221robotics/RobotOpen-Pneumatic-Shield/sunstone.png

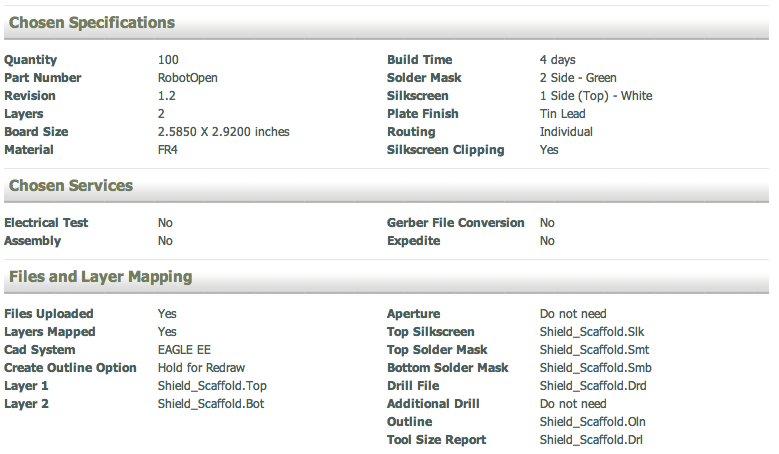
sunstone.png
