221robotics/RobotOpen-Pneumatic-Shield/pneumatic_board2.brd

## EAGLE design pneumatic_board2.brd (2012-09-11)

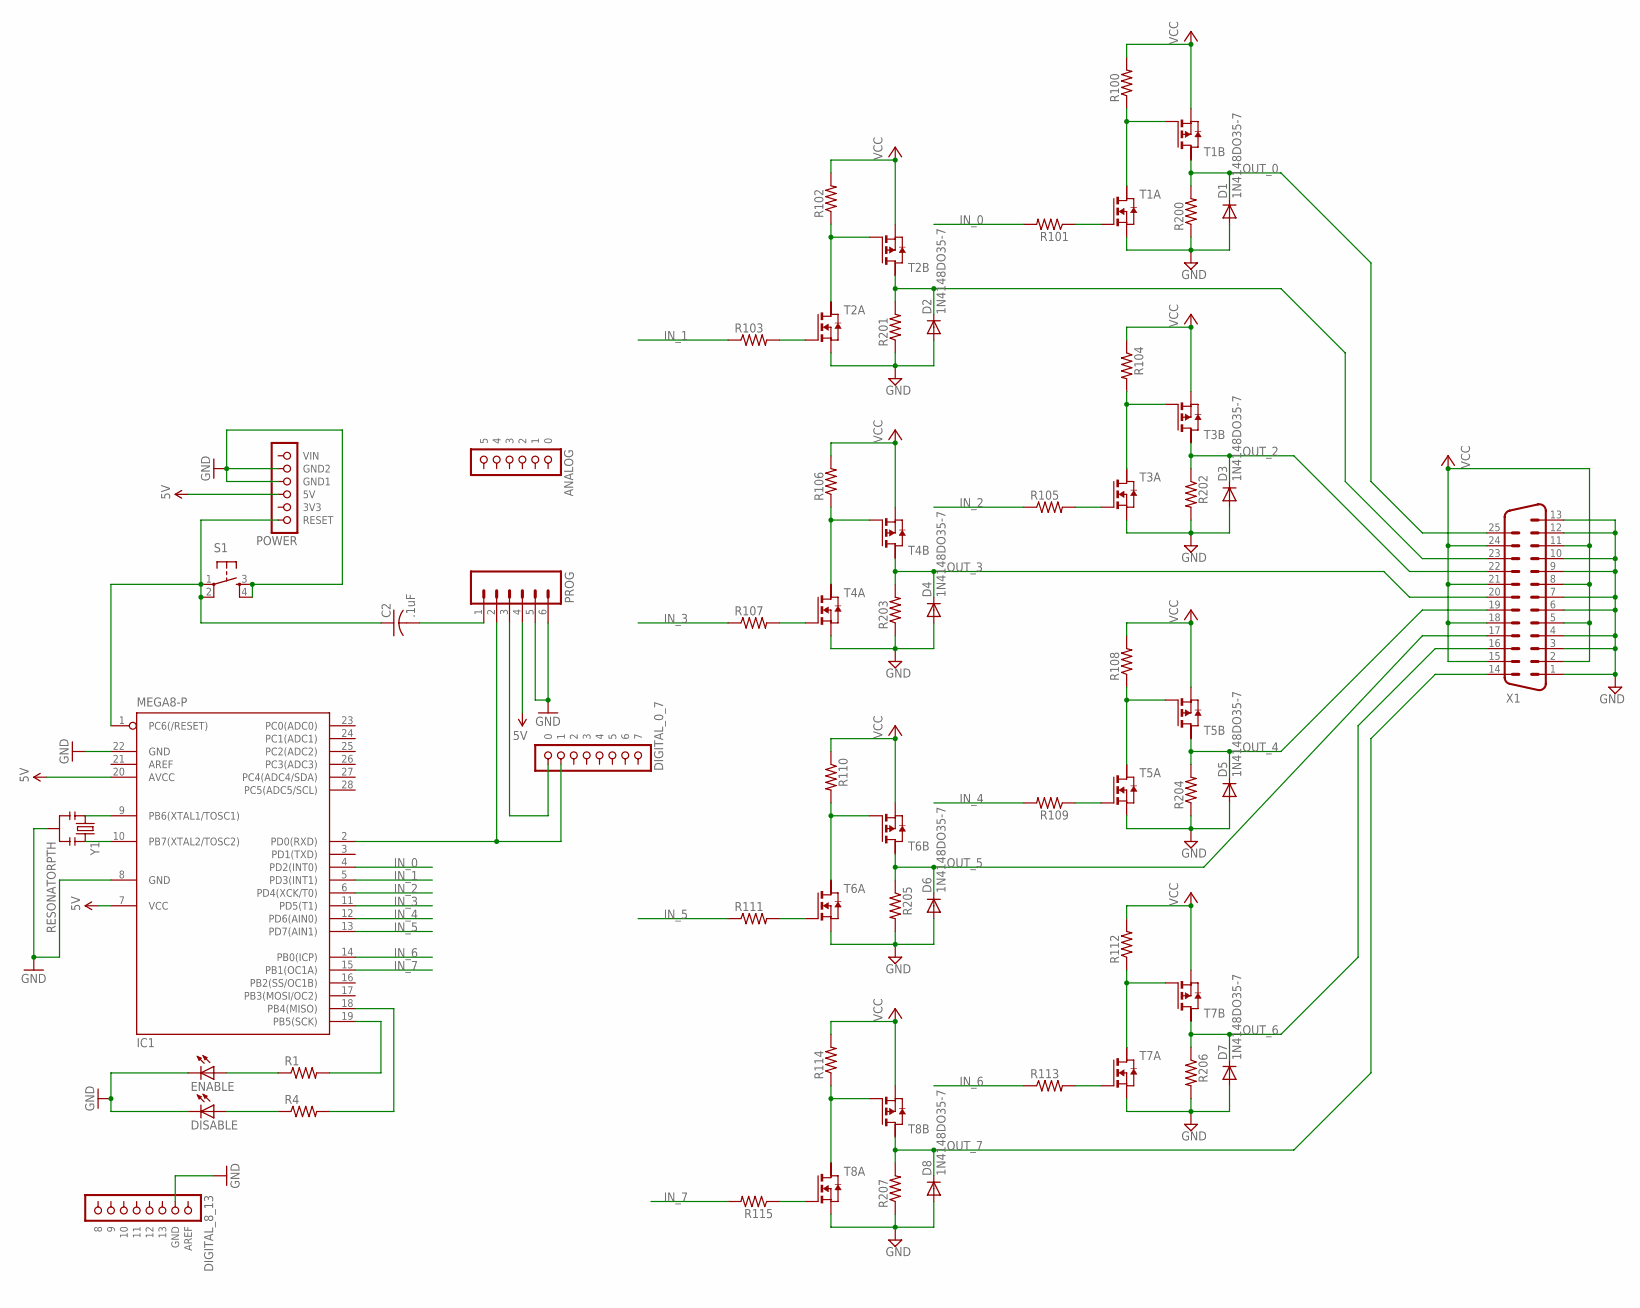
[picture p2: schematic pneumatic_board2.sch]

Parts:
C2: .1uF; C025-024X044
D1, D2, D3, D4, D5, D6, D7, D8: 1N4148DO35-7; DO35-7
DISABLE: LED5MM
ENABLE: LED5MM
IC1: MEGA8-P; DIL28-3
PROG: M06SIP_LOCK; 1X06-SIP_LOCK
R1, R4, R100, R101, R102, R103, R104, R105, R106, R107, R108, R109, R110, R111, R112, R113, R114, R115, R200, R201, R202, R203, R204, R205, R206, R207: RESISTORAXIAL-0.3; AXIAL-0.3
S1: TAC_SWITCHPTH; TACTILE-PTH
T1, T2, T3, T4, T5, T6, T7, T8: PN_MOSFET-SO8; SO8
U$1: POWER; 1X06
U$2: ANALOG; 1X06
U$3: DIGITAL_0_7; 1X08
U$4: DIGITAL_8_13; 1X08
X1: M25VP
Y1: RESONATORPTH; RESONATOR-PTH

Connections:
5V: IC1.7 (VCC), IC1.20 (AVCC), PROG.4, U$1.3 (5V)
GND: D1.A, D2.A, D3.A, D4.A, D5.A, D6.A, D7.A, D8.A, DISABLE.K (C), ENABLE.K (C), IC1.8 (GND), IC1.22 (GND), PROG.5, PROG.6, R200.P$1 (1), R201.P$1 (1), R202.P$2 (2), R203.P$1 (1), R204.P$1 (1), R205.P$2 (2), R206.P$2 (2), R207.P$1 (1), S1.3, S1.4, T1.1 (S), T2.1 (S), T3.1 (S), T4.1 (S), T5.1 (S), T6.1 (S), T7.1 (S), T8.1 (S), U$1.4 (GND1), U$1.5 (GND2), U$4.2 (GND), X1.1, X1.3, X1.4, X1.6, X1.7, X1.9, X1.10, X1.12, X1.13, Y1.2
IN_0: IC1.4 (PD2(INT0)), R101.P$2 (2)
IN_1: IC1.5 (PD3(INT1)), R103.P$1 (1)
IN_2: IC1.6 (PD4(XCK/T0)), R105.P$1 (1)
IN_3: IC1.11 (PD5(T1)), R107.P$1 (1)
IN_4: IC1.12 (PD6(AIN0)), R109.P$2 (2)
IN_5: IC1.13 (PD7(AIN1)), R111.P$1 (1)
IN_6: IC1.14 (PB0(ICP)), R113.P$1 (1)
IN_7: IC1.15 (PB1(OC1A)), R115.P$2 (2)
unnamed: IC1.2 (PD0(RXD)), PROG.2, U$3.7 (1)
unnamed: IC1.9 (PB6(XTAL1/TOSC1)), Y1.1
unnamed: IC1.10 (PB7(XTAL2/TOSC2)), Y1.3
unnamed: IC1.19 (PB5(SCK)), R1.P$2 (2)
unnamed: IC1.18 (PB4(MISO)), R4.P$2 (2)
unnamed: R100.P$1 (1), T1.4 (G), T1.7 (D)
unnamed: R101.P$1 (1), T1.2 (G)
unnamed: R104.P$2 (2), T3.4 (G), T3.7 (D)
unnamed: R102.P$1 (1), T2.4 (G), T2.7 (D)
unnamed: R103.P$2 (2), T2.2 (G)
unnamed: R105.P$2 (2), T3.2 (G)
unnamed: R106.P$1 (1), T4.4 (G), T4.7 (D)
unnamed: R107.P$2 (2), T4.2 (G)
unnamed: R108.P$1 (1), T5.4 (G), T5.7 (D)
unnamed: R109.P$1 (1), T5.2 (G)
unnamed: R110.P$2 (2), T6.4 (G), T6.7 (D)
unnamed: R111.P$2 (2), T6.2 (G)
unnamed: PROG.3, U$3.8 (0)
unnamed: ENABLE.A, R1.P$1 (1)
unnamed: DISABLE.A, R4.P$1 (1)
unnamed: R112.P$1 (1), T7.4 (G), T7.7 (D)
unnamed: R113.P$2 (2), T7.2 (G)
unnamed: R114.P$1 (1), T8.4 (G), T8.7 (D)
unnamed: R115.P$1 (1), T8.2 (G)
unnamed: C2.2, PROG.1
unnamed: C2.1, IC1.1 (PC6(/RESET)), S1.1, S1.2, U$1.1 (RESET)
OUT_0: D1.C, R200.P$2 (2), T1.5 (D), X1.25
OUT_1: D2.C, R201.P$2 (2), T2.5 (D), X1.23
OUT_2: D3.C, R202.P$1 (1), T3.5 (D), X1.22
OUT_3: D4.C, R203.P$2 (2), T4.5 (D), X1.20
OUT_4: D5.C, R204.P$2 (2), T5.5 (D), X1.19
OUT_5: D6.C, R205.P$1 (1), T6.5 (D), X1.17
OUT_6: D7.C, R206.P$1 (1), T7.5 (D), X1.16
OUT_7: D8.C, R207.P$2 (2), T8.5 (D), X1.14
VCC: R100.P$2 (2), R102.P$2 (2), R104.P$1 (1), R106.P$2 (2), R108.P$2 (2), R110.P$1 (1), R112.P$2 (2), R114.P$2 (2), T1.3 (S), T2.3 (S), T3.3 (S), T4.3 (S), T5.3 (S), T6.3 (S), T7.3 (S), T8.3 (S), X1.2, X1.5, X1.8, X1.11, X1.15, X1.18, X1.21, X1.24

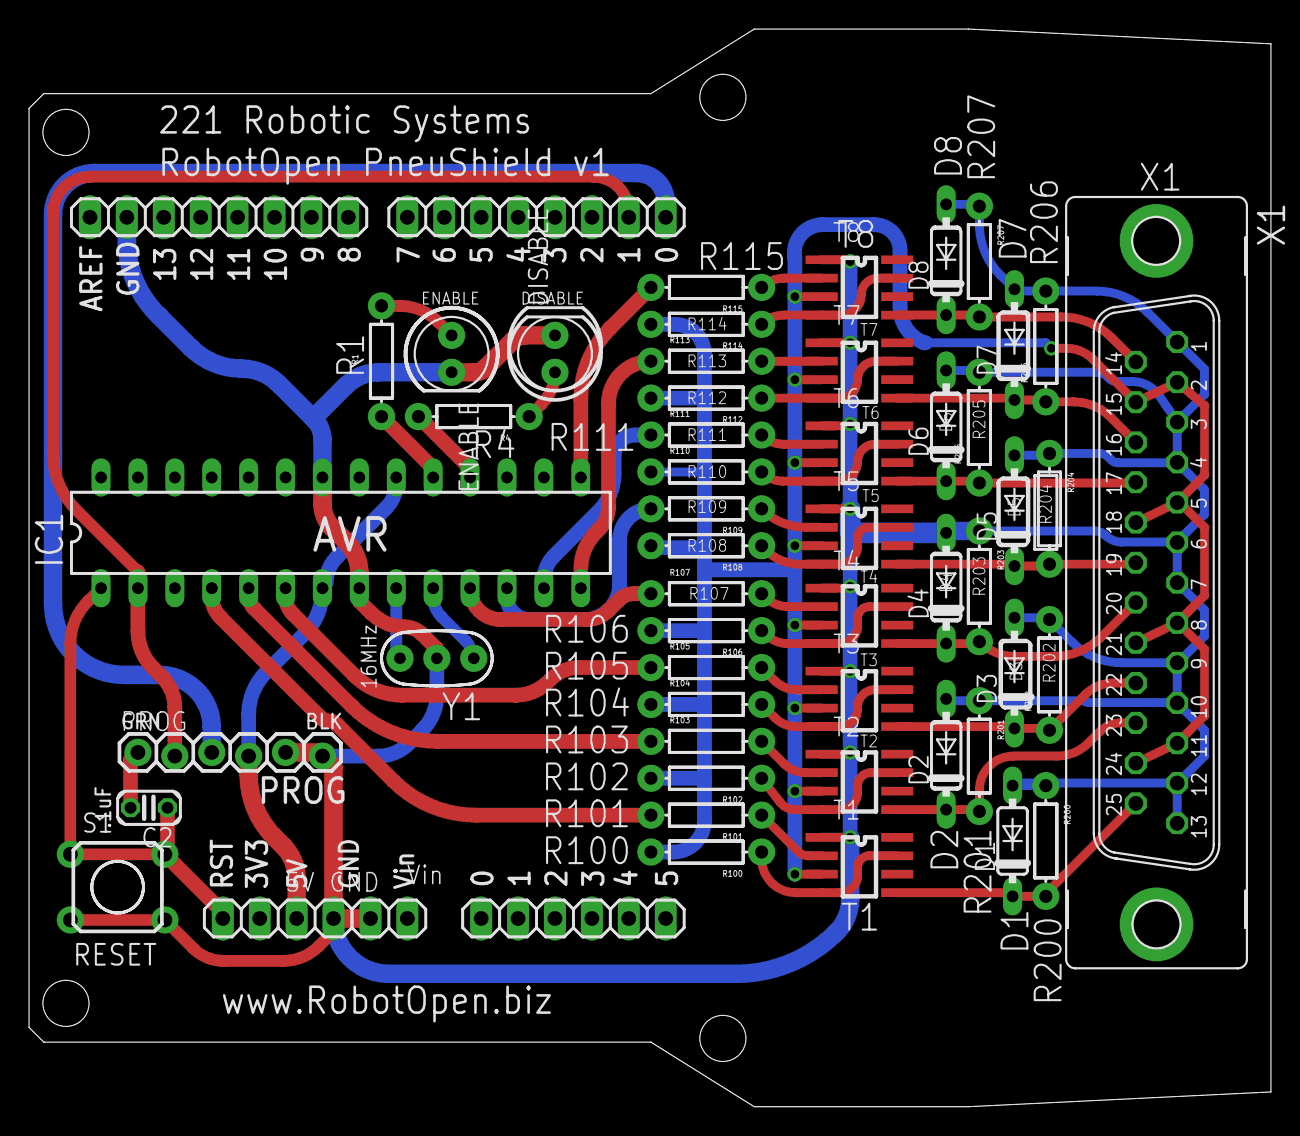
[picture p3: board pneumatic_board2.brd from above]

Board: 2 copper layers, 85.5 x 74.2 mm, 54 parts (0 on the bottom side), 45 nets.
