221robotics/RobotOpen-Pneumatic-Shield/(commit log)

2012-09-11 Initial commit - order sent to Sunstone.
    [pneumatic_board2.brd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]
2012-09-12 Removed old files.
    [pneumatic_board2.GBL, pneumatic_board2.GBO, pneumatic_board2.GBS, pneumatic_board2.GTL, pneumatic_board2.GTO, pneumatic_board2.GTP, pneumatic_board2.GTS]
